partyvi/Pypilot_motor_DRV8873H/Hardware/Board model.jpg

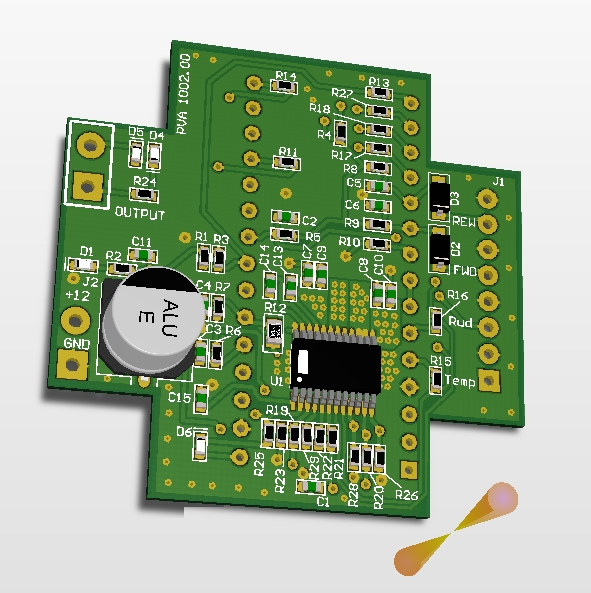
Hardware/Board model.jpg
