partyvi/Pypilot_motor_DRV8873H/Hardware/1.jpg

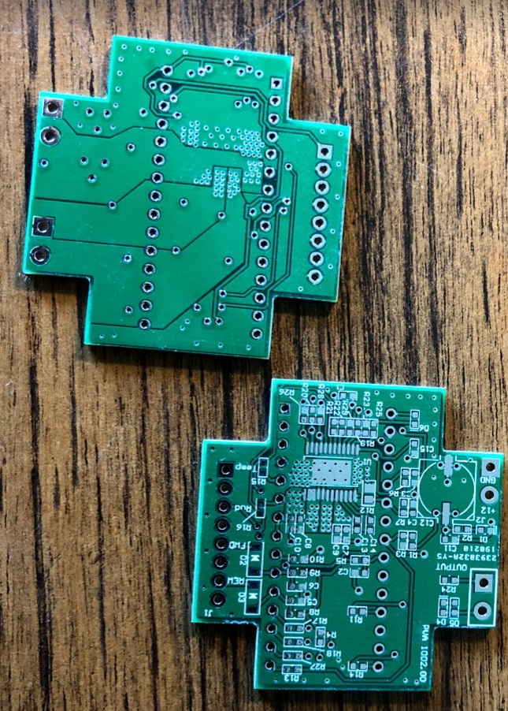
Hardware/1.jpg
