partyvi/Pypilot_motor_DRV8873H/README.md

# Pypilot_motor_DRV8873H
Motor driver board for pypilot Opensource Software project

/* Copyright (C) 2019 Viktor Partyshev <partyvi@gmail.com>
 *
 * This matherials are free; you can redistribute it and/or
 * modify it for your OWN purpose, any commercial usage has to be 
 * approved by author.
 */
 
 This hardware expected to work with modified version of arduino software 
 https://github.com/partyvi/pypilot/tree/master/arduino/motor
 Code tested under arduino 1.6.10 , but must be functional with most ricent versions
