partyvi/Pypilot_motor_DRV8873H/Firmware/README.md

# Pypilot_motor_DRV8873H

Software is stored in https://github.com/partyvi/pypilot/tree/master/arduino/motor
Wecome to take and use it.
