partyvi/Pypilot_motor_DRV8873H/Hardware/Real view with arduino.jpg

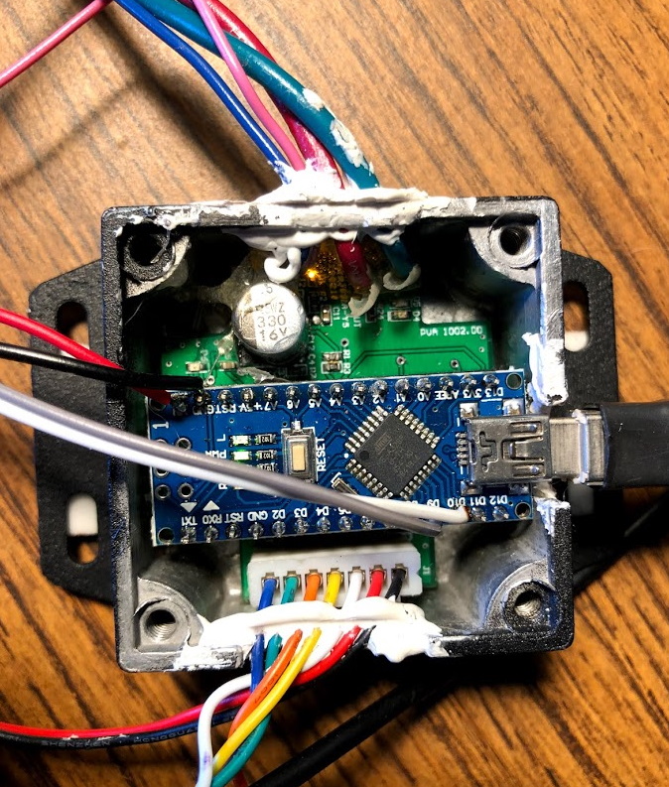
Hardware/Real view with arduino.jpg
