partyvi/Pypilot_motor_DRV8873H/Hardware/Real view without arduino 1.jpg

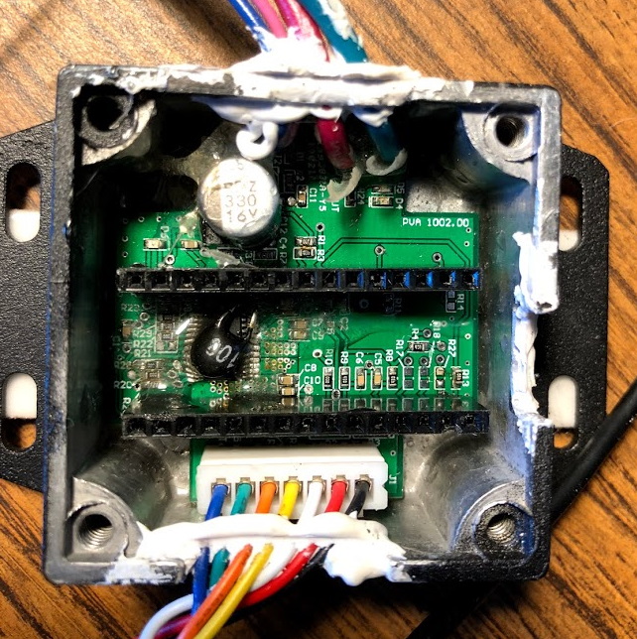
Hardware/Real view without arduino 1.jpg
