partyvi/Pypilot_motor_DRV8873H/Hardware/motor_drv8873.step

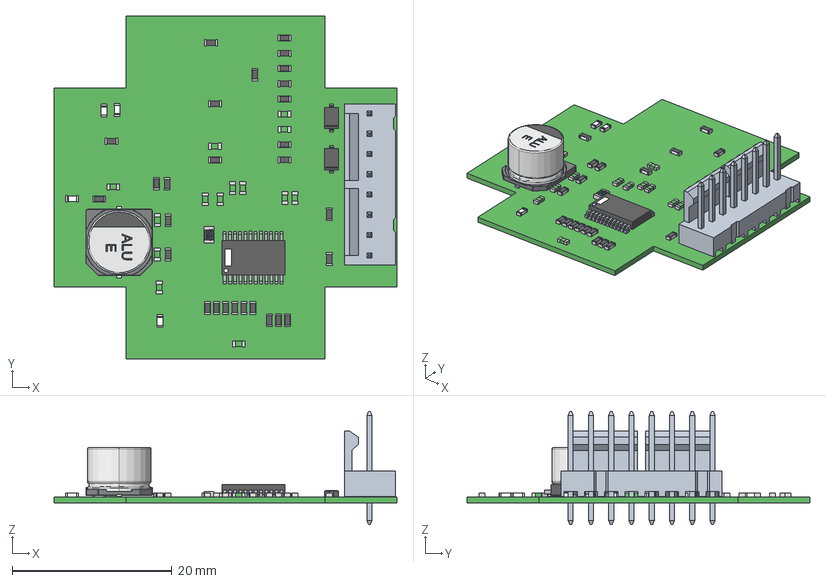
[picture p5: CAD file, 2019-07-21]
Hardware/motor_drv8873.step
43.0 x 43.0 x 14.2 mm
Board
Extruded x 513
User_Library-ALU-E_Pins_1
User_Library-ALU-E_Fuss_1
User_Library-ALU-E_K_X_F6rper_1
User_Library-ALU-E_Beschriftung_1
