partyvi/Pypilot_motor_DRV8873H/(commit log)

2019-07-21 Board design commit rev.1 Initial design. Tested and working on my "Sea sun"
    [motor_drv8873.step]
2019-07-21 Added support for DRV8873H 8 AMPS H Bridge and to AS5601 rotation sensor
2019-11-23 Motor arduino firmware added
